LeonardoLisa/IN-12A-four-digits-Nixie-clock/Hardware/Pictures/Main-board_with_nixie.jpg

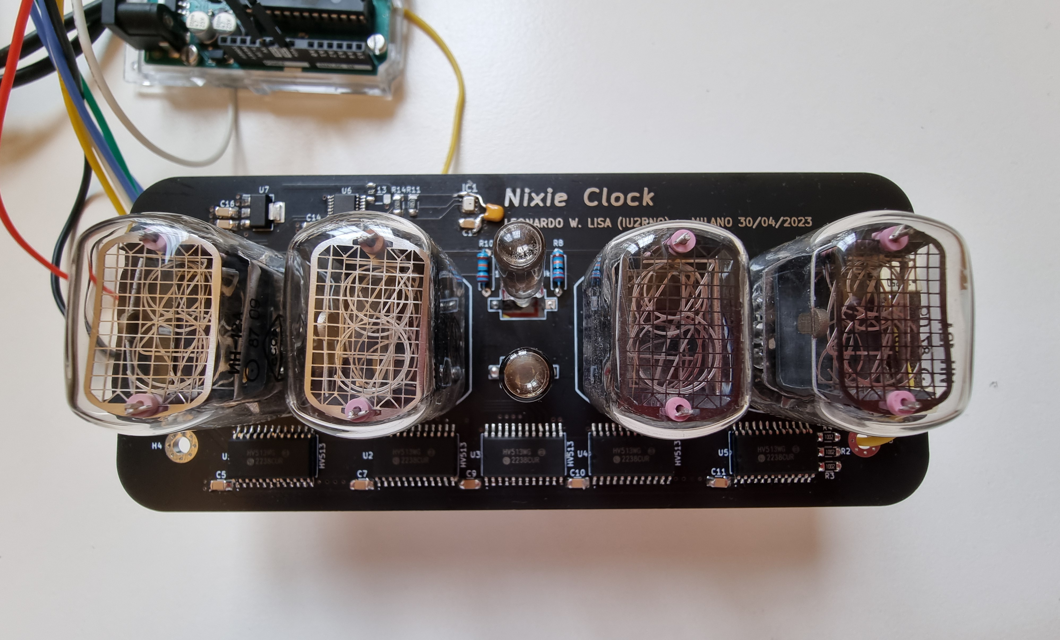
Hardware/Pictures/Main-board_with_nixie.jpg
