LeonardoLisa/IN-12A-four-digits-Nixie-clock/Hardware/Case/BOM-mechanical-assembly.xlsx

Sheet: BOM-miscellaneous-components
Components | Description | Qty
DS3231 rtc module | - | 1
High voltage DC-DC converter | - | 1
Push switch | - | 3
Arduino mini | Use only Arduino board based on ATmega328 | 1
Low voltage DC-DC converter | Not necessary, depends on you power adapter | 1

Sheet: BOM-mechanical-assembly
Components | Description | Qty
M3 15mm screw | Case mounting screw | 4
M3 5mm screw | Feet mounting screw | 2
M3 nut | - | 6
DC Barrel Jack 5.5mm | SK6812MINI | 1

Sheet: BOM-main-board
Reference | Value | Footprint | Qty
C1,C2,C3,C4,C5,C6,C7,C8,C9,C10,C11,C12,C13,C14,C15,C17 | 100n | -- mixed values -- | 16
C16 | 22u | Capacitor_SMD:C_1206_3216Metric_Pad1.33x1.80mm_HandSolder | 1
D1,D2 | 33V | Diode_THT:D_A-405_P7.62mm_Horizontal | 2
D3,D4,D5,D6 | SK6812MINI | LED_SMD:LED_SK6812MINI_PLCC4_3.5x3.5mm_P1.75mm | 4
H1,H2,H3,H4 | MountingHole_Pad | MountingHole:MountingHole_3.2mm_M3_Pad_Via | 4
IC1 | HS3001 | RenesasFootprints:HS3001 | 1
J1 | Conn_01x01_Male | Connector_Pin:Pin_D0.7mm_L6.5mm_W1.8mm_FlatFork | 1
J2 | Conn_01x08_Male | Connector_PinHeader_2.54mm:PinHeader_2x04_P2.54mm_Vertical | 1
NX1,NX2,NX3,NX4* | IN-12A | nixie:Nixie-IN-12 | 4
R1 | 150k | Resistor_THT:R_Axial_DIN0207_L6.3mm_D2.5mm_P7.62mm_Horizontal | 1
R2,R3,R4 | 10k | Resistor_SMD:R_1206_3216Metric_Pad1.30x1.75mm_HandSolder | 3
R5,R6,R7,R9 | 22k | Resistor_THT:R_Axial_DIN0207_L6.3mm_D2.5mm_P7.62mm_Horizontal | 4
R8,R10 | 200k | Resistor_THT:R_Axial_DIN0207_L6.3mm_D2.5mm_P7.62mm_Horizontal | 2
R11,R12,R13 | 100k | Resistor_SMD:R_1206_3216Metric_Pad1.30x1.75mm_HandSolder | 3
U1,U2,U3,U4,U5 | HV513WG-G | footprints:HV513WG-G | 5
U6 | TXB0108PWR | Package_SO:TSSOP-20_4.4x6.5mm_P0.65mm | 1
U7 | LD1117S33TR_SOT223 | Package_TO_SOT_SMD:SOT-223-3_TabPin2 | 1
V1,V2 | INS-1 | nixie:IN-3 | 2
*You also need to find 48 sockets pins (12 for each tube). Those pins are available on aliexpress or you can disassemble a D-SUB connector to harvast them.
