LeonardoLisa/IN-12A-four-digits-Nixie-clock/Hardware/Schematic_IN-12-Nixie-Clock-Multiplexer.pdf

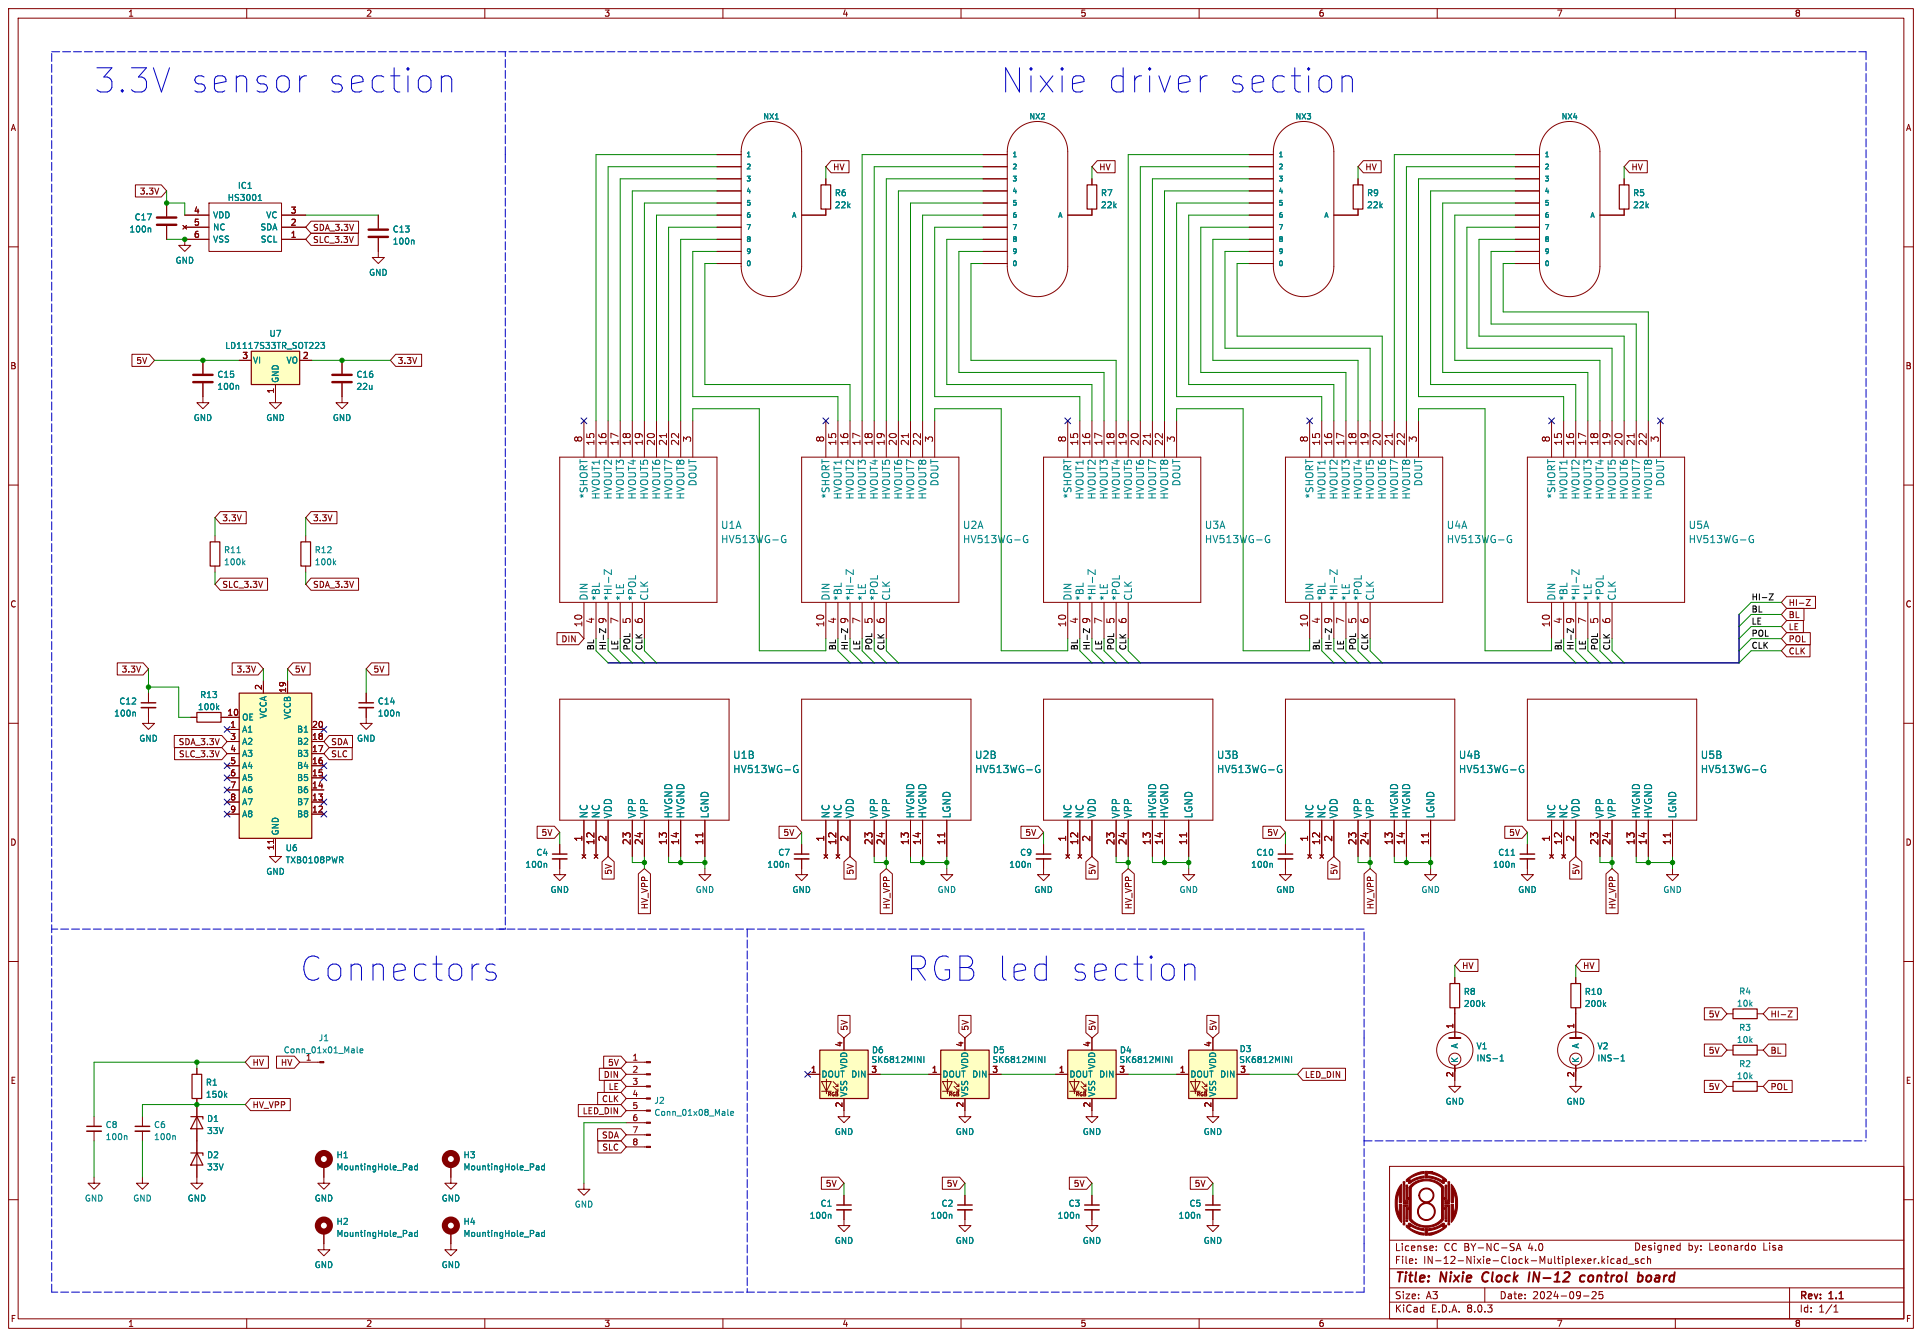
[picture p5: page 1]

POL BL HI-Z POL
LECLK

1 LGND 11 NC 12 HVGND 13 HVGND 14 VDD

2 VPP 23 VPP 24 GND GND
