LeonardoLisa/IN-12A-four-digits-Nixie-clock/Firmware/Nixie-clock/rainbow_table.h

/*
 * rainbow_table.h
 *
 * Created: 02/01/2020 21:57:19
 * Author: Leonardo Lisa
 *
 */ 

#include "SK6812.h"

#ifndef RAINBOW_TABLE_H_
#define RAINBOW_TABLE_H_

#define NO_COLOR 360

const rgb_colour rainbow[361] = {
	(rgb_colour){255, 0, 0},
	(rgb_colour){255, 4, 0},
	(rgb_colour){255, 8, 0},
	(rgb_colour){255, 12, 0},
	(rgb_colour){255, 17, 0},
	(rgb_colour){255, 21, 0},
	(rgb_colour){255, 25, 0},
	(rgb_colour){255, 29, 0},
	(rgb_colour){255, 34, 0},
	(rgb_colour){255, 38, 0},
	(rgb_colour){255, 42, 0},
	(rgb_colour){255, 46, 0},
	(rgb_colour){255, 51, 0},
	(rgb_colour){255, 55, 0},
	(rgb_colour){255, 59, 0},
	(rgb_colour){255, 63, 0},
	(rgb_colour){255, 68, 0},
	(rgb_colour){255, 72, 0},
	(rgb_colour){255, 76, 0},
	(rgb_colour){255, 80, 0},
	(rgb_colour){255, 85, 0},
	(rgb_colour){255, 89, 0},
	(rgb_colour){255, 93, 0},
	(rgb_colour){255, 97, 0},
	(rgb_colour){255, 102, 0},
	(rgb_colour){255, 106, 0},
	(rgb_colour){255, 110, 0},
	(rgb_colour){255, 114, 0},
	(rgb_colour){255, 119, 0},
	(rgb_colour){255, 123, 0},
	(rgb_colour){255, 127, 0},
	(rgb_colour){255, 131, 0},
	(rgb_colour){255, 136, 0},
	(rgb_colour){255, 140, 0},
	(rgb_colour){255, 144, 0},
	(rgb_colour){255, 148, 0},
	(rgb_colour){255, 153, 0},
	(rgb_colour){255, 157, 0},
	(rgb_colour){255, 161, 0},
	(rgb_colour){255, 165, 0},
	(rgb_colour){255, 170, 0},
	(rgb_colour){255, 174, 0},
	(rgb_colour){255, 178, 0},
	(rgb_colour){255, 182, 0},
	(rgb_colour){255, 187, 0},
	(rgb_colour){255, 191, 0},
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
	(rgb_colour){255, 0, 34},
	(rgb_colour){255, 0, 30},
	(rgb_colour){255, 0, 26},
	(rgb_colour){255, 0, 22},
	(rgb_colour){255, 0, 17},
	(rgb_colour){255, 0, 13},
	(rgb_colour){255, 0, 9},
	(rgb_colour){255, 0, 5},
	(rgb_colour){0, 0, 0},
};

#endif /* RAINBOW_TABLE_H_ */
